tohma-k/ai-vision-tracker/assets/mounted-webcam.jpg

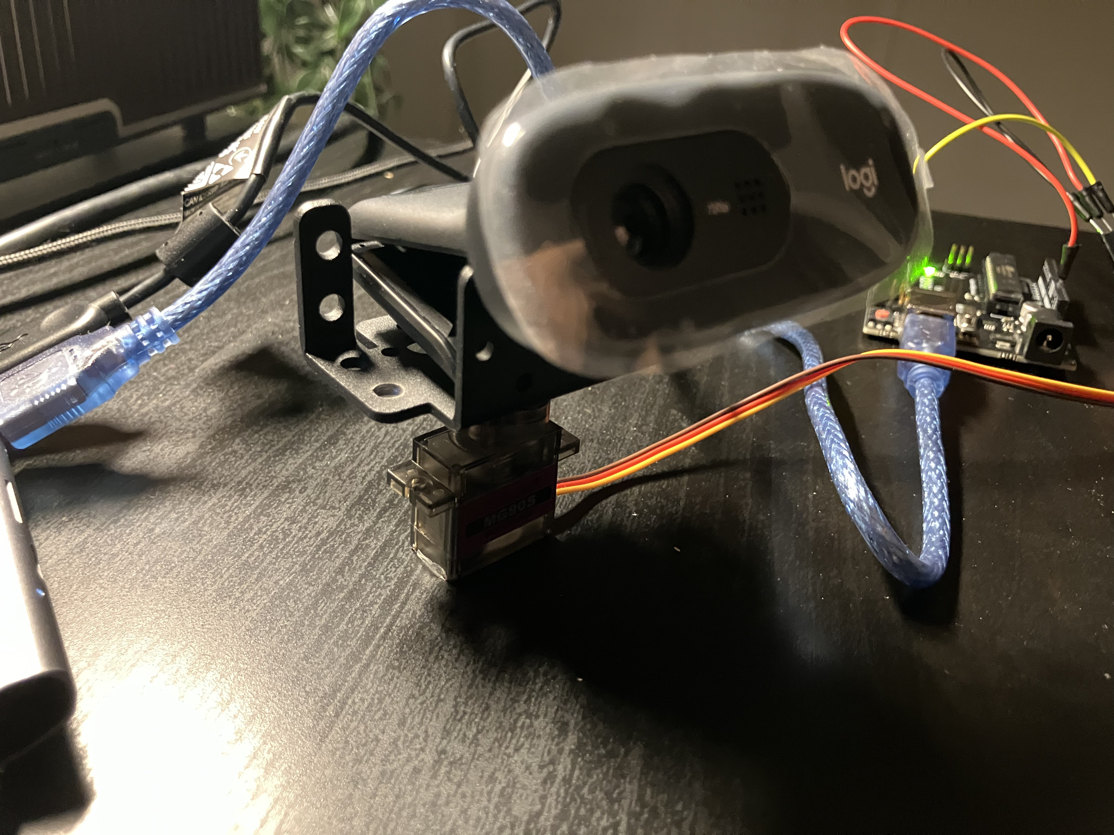
assets/mounted-webcam.jpg
