tohma-k/ai-vision-tracker/assets/bracket-assembly.jpg

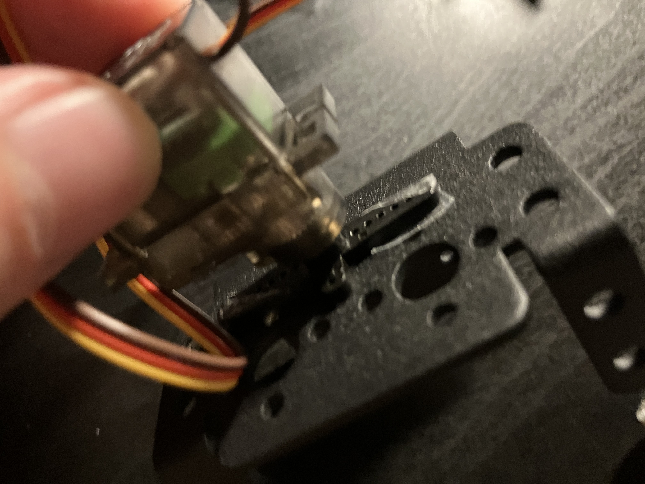
assets/bracket-assembly.jpg
