tohma-k/ai-vision-tracker/assets/wiring.jpg

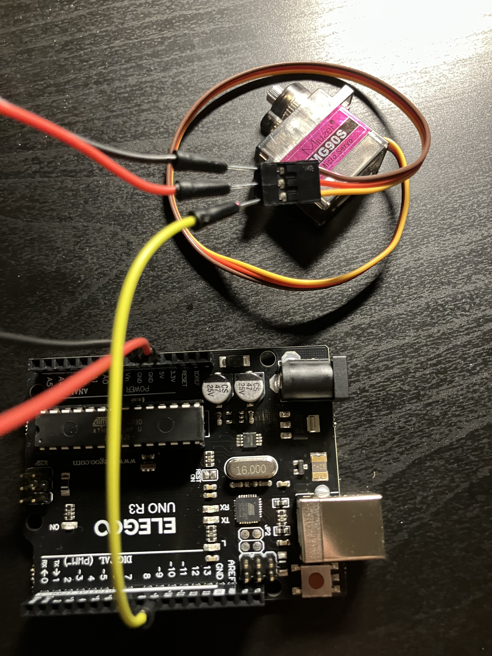
assets/wiring.jpg
