tohma-k/ai-vision-tracker/(commit log)

2026-05-27 Initial AI vision tracking prototype
2026-05-28 Add servo control demo video and pic
2026-05-28 Implement Python to Arduino servo control
2026-05-28 Document bracket mounting
2026-05-28 Add tracking stability tuning
    [ai_servo_tracking.py]
2026-05-28 Implement AI-controlled servo tracking
2026-05-28 Document AI servo tracking system architecture and integration
2026-05-28 Add Arduino servo control firmware
2026-05-29 Add proportional servo control
2026-05-29 Document AI servo tracking system
2026-06-07 Resize camera input
2026-06-07 Tested threaded camera capture optimization
2026-06-07 Revert threaded camera capture optimization
    [ai_servo_tracking.py]
2026-06-08 Add 2-servo Arduino code
2026-06-08 Document shift to dual-axis servo control
2026-06-10 Document dual-servo hardware updates
2026-06-10 Document conclusion of phase 6 - dual-axis servo control
2026-06-10 Update README for dual-servo ai tracking system
